nilan-y/Mini-IPA/Layout/Layout.csv

ID | Bezeichner | Footprint | Stückzahl | Bezeichnung | Anbieter und Referenz
1 | C14 | C_0402_1005Metric | 1 | 10uF
2 | C1,C2 | C_0402_1005Metric | 2 | 1uF
3 | R13 | R_2512_6332Metric | 1 | shunt
4 | R4 | R_0603_1608Metric | 1 | 0R
5 | TP2,TP1,TP7,TP14,TP3,TP15,TP16,TP8,TP12,TP5,TP4,TP6 | TestPoint_Pad_D1.0mm | 12 | Testpoint
6 | J3 | PinHeader_1x03_P2.54mm_Vertical | 1 | Conn_01x03_Pin
7 | C7,C12,C5,C8,C11,C4,C16,C17,C10,C19,C13,C9,C3,C6 | C_0402_1005Metric | 14 | 100nF
8 | R10,R2,R3,R9 | R_0402_1005Metric | 4 | 10k
9 | SW3,SW1 | SW_SPST_B3S-1000 | 2 | SW_Omron_B3FS
10 | J2 | USB_Micro-B_Amphenol_10118193-0001LF_Horizontal | 1 | USB_B_Micro
11 | Y1 | SG210STF480000ML5 | 1 | SG-210STF_8.0000ML5
12 | D2,D4,D5 | LED_0603_1608Metric | 3 | BLUE LED
13 | R7,R5,R6 | R_0402_1005Metric | 3 | 390R
14 | R8 | R_0402_1005Metric | 1 | 680R
15 | C18 | C_0402_1005Metric | 1 | n/a
16 | J1 | PinHeader_1x07_P2.54mm_Vertical_SMD_Pin1Left | 1 | Conn_01x07_Pin
17 | R18,R12,R19,R11 | R_0402_1005Metric | 4 | n/a
18 | U3 | SOT-23-5 | 1 | XC6210B332MR
19 | R21 | R_0402_1005Metric | 1 | 1k
20 | D1 | LED_0603_1608Metric | 1 | YELLOW LED
21 | IC3 | uC_Footprint | 1 | STM32F042G4U6
22 | IC4 | SOT-23-6 | 1 | MAX4231AUT+T
23 | R16 | R_0402_1005Metric | 1 | 8.2k
24 | R1 | R_0402_1005Metric | 1 | 330R
25 | R15 | R_0402_1005Metric | 1 | 10R
26 | U1 | SOT-23-5 | 1 | INA197
27 | IC1 | VL53L4CDV0DH1 | 1 | VL53L4CDV0DH_1
28 | R14 | R_0402_1005Metric | 1 | 470R
29 | D7 | RLD65NZN500A | 1 | RLD65NZN5-00A
30 | TP9,TP11,TP10 | TestPoint_Pad_2.5x2.5mm | 3 | TestPoint
31 | TR1 | SOT-23-3 | 1 | 2N7002AQ-7
32 | RN1 | R_Array_Concave_4x0603 | 1 | 100R 4x0603
33 | U4 | SOT-23-6 | 1 | ~
34 | U6 | SOT-23-6 | 1 | USBLC6-2SC6
35 | J4 | PinHeader_1x04_P2.54mm_Vertical | 1 | Conn_01x04_Pin
