nilan-y/Mini-IPA/Layout/Layout.kicad_pcb

## KiCad design Layout/Layout.kicad_pcb (2026-10-27)

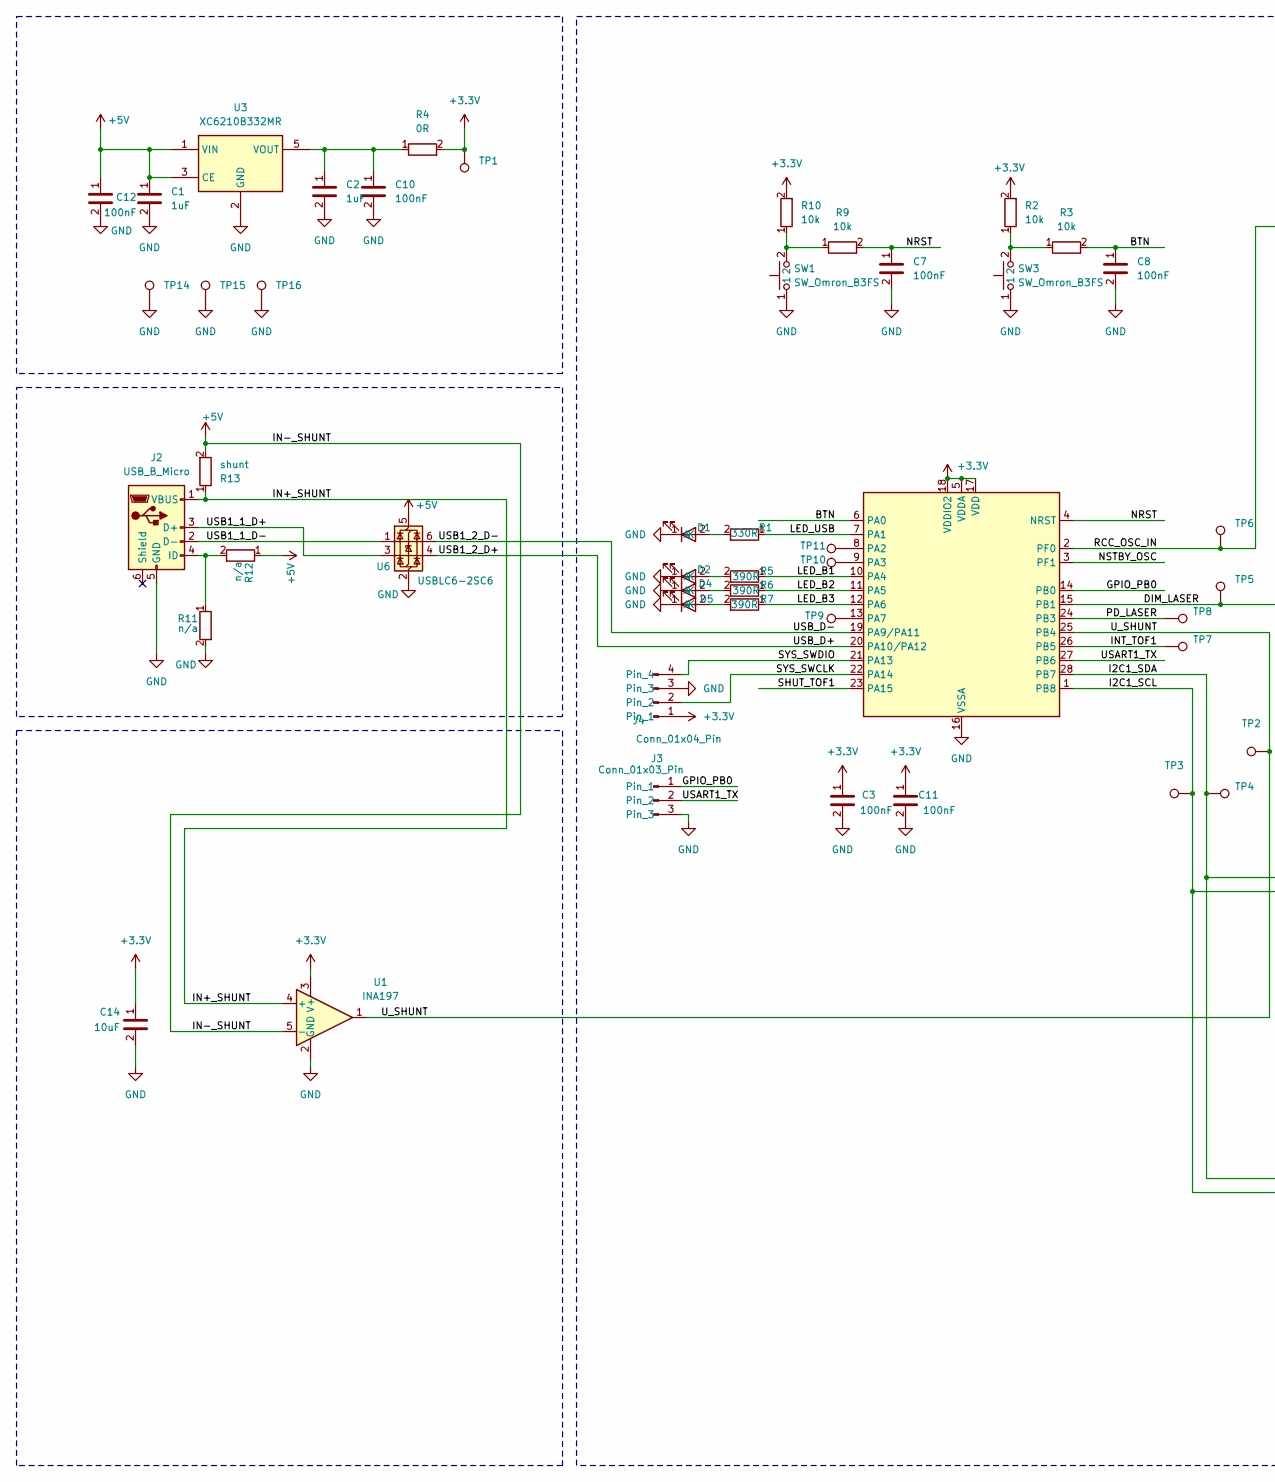
[picture p1: schematic Layout.kicad_sch, part in row 1, column 1]

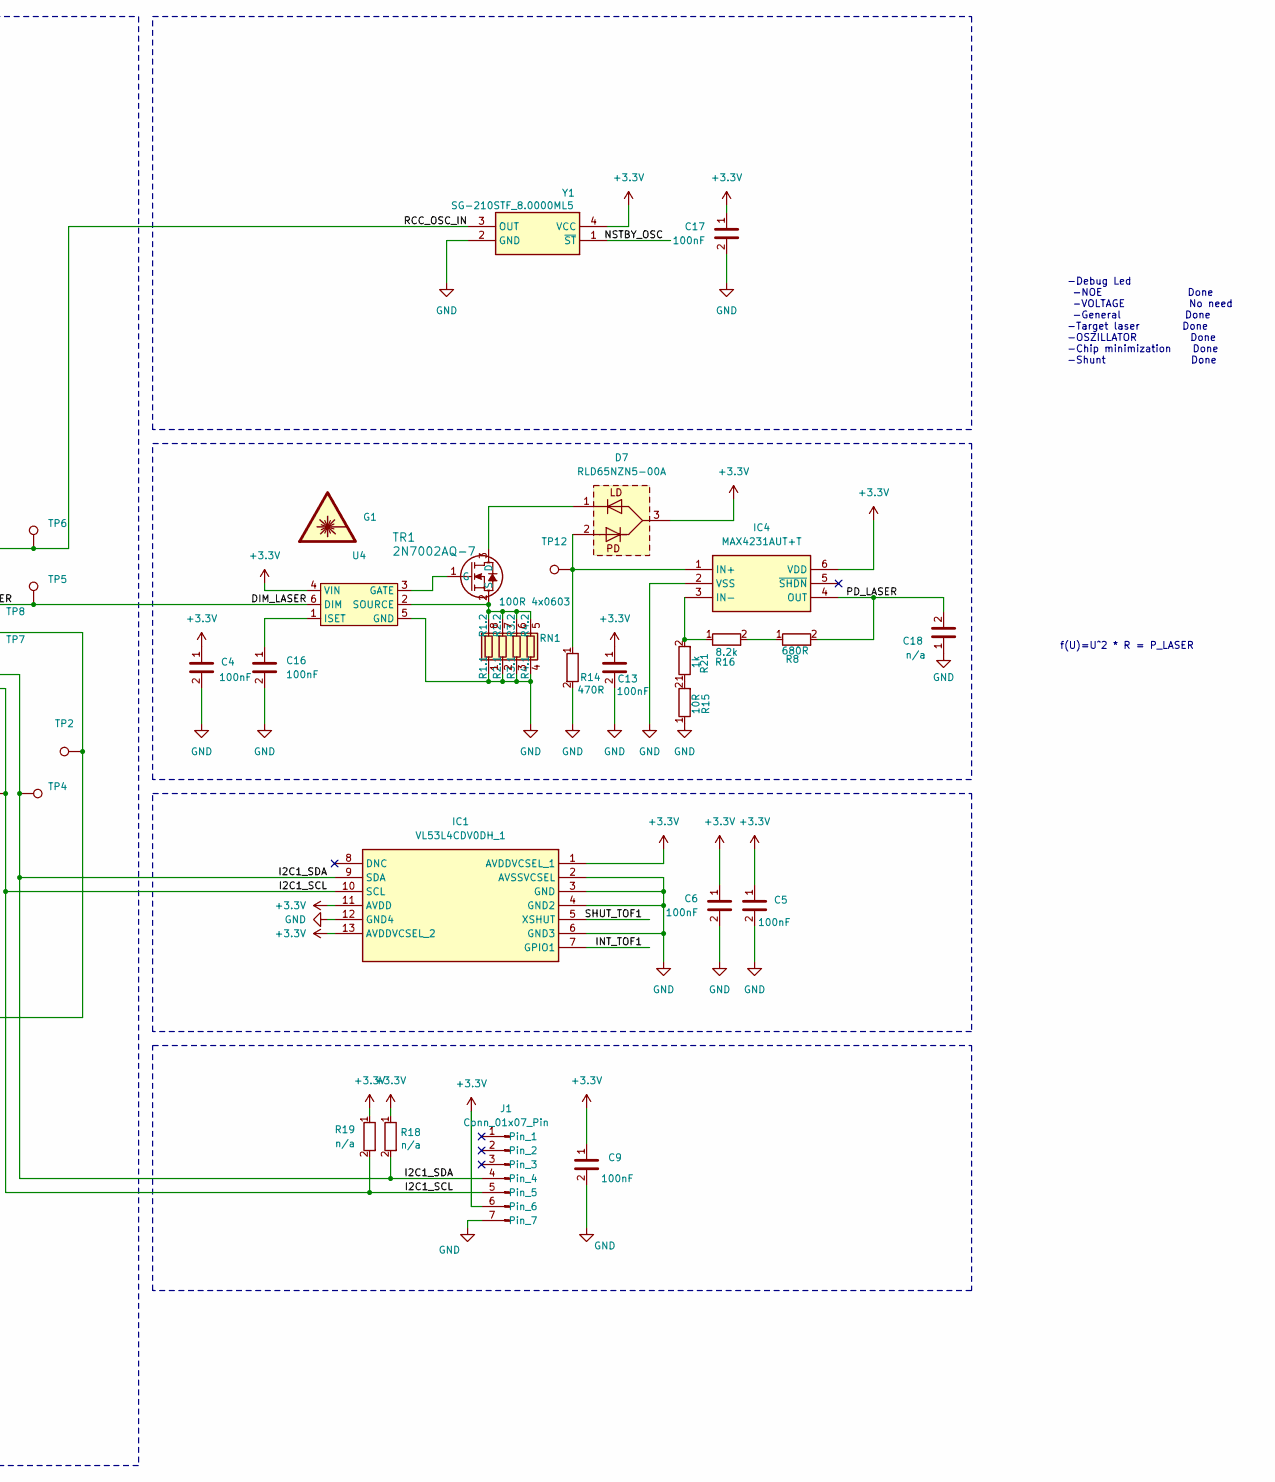
[picture p2: schematic Layout.kicad_sch, part in row 1, column 2]

Parts:
C1, C2: 1uF; C_0402_1005Metric
C3, C4, C5, C6, C7, C8, C9, C10, C11, C12, C13, C16, C17: 100nF; C_0402_1005Metric
C14: 10uF; C_0402_1005Metric
C18: n/a; C_0402_1005Metric
D1: YELLOW LED; LED_0603_1608Metric
D2, D4, D5: BLUE LED; LED_0603_1608Metric
D7: RLD65NZN5-00A; RLD65NZN500A; Mouser Part Number 755-RLD65NZN5-00A
G1: Laser_Warnschild
IC1: VL53L4CDV0DH_1; VL53L4CDV0DH1; Mouser Part Number 511-VL53L4CDV0DH/1
IC3: STM32F042G4U6; uC_Footprint; Mouser Part Number 511-STM32F042G4U6
IC4: MAX4231AUT+T; SOT-23-6; Mouser Part Number 700-MAX4231AUTT
J1: Conn_01x07_Pin; PinHeader_1x07_P2.54mm_Vertical_SMD_Pin1Left
J2: USB_B_Micro; USB_Micro-B_Amphenol_10118193-0001LF_Horizontal
J3: Conn_01x03_Pin; PinHeader_1x03_P2.54mm_Vertical
J4: Conn_01x04_Pin; PinHeader_1x04_P2.54mm_Vertical
R1: 330R; R_0402_1005Metric
R2, R3, R9, R10: 10k; R_0402_1005Metric
R4: 0R; R_0603_1608Metric
R5, R6, R7: 390R; R_0402_1005Metric
R8: 680R; R_0402_1005Metric
R11, R12, R18, R19: n/a; R_0402_1005Metric
R13: shunt; R_2512_6332Metric
R14: 470R; R_0402_1005Metric
R15: 10R; R_0402_1005Metric
R16: 8.2k; R_0402_1005Metric
R21: 1k; R_0402_1005Metric
RN1: 100R 4x0603; R_Array_Concave_4x0603
SW1, SW3: SW_Omron_B3FS; SW_SPST_B3S-1000
TP1, TP2, TP3, TP4, TP5, TP6, TP7, TP8, TP12, TP14, TP15, TP16: Testpoint; TestPoint_Pad_D1.0mm
TP9, TP10, TP11: TestPoint; TestPoint_Pad_2.5x2.5mm
TR1: 2N7002AQ-7; SOT-23-3
U1: INA197; SOT-23-5
U3: XC6210B332MR; SOT-23-5
U4: SOT-23-6
U6: USBLC6-2SC6; SOT-23-6
Y1: SG-210STF_8.0000ML5; SG210STF480000ML5; Mouser Part Number 732-SG-210STF48.0ML5

Connections:
+3.3V: C3.1, C4.1, C5.1, C6.1, C9.1, C11.1, C13.1, C14.1, C17.1, D7.3, IC1.1 (AVDDVCSEL_1), IC1.11 (AVDD), IC1.13 (AVDDVCSEL_2), IC3.5 (VDDA), IC3.17 (VDD), IC3.18 (VDDIO2), IC4.6 (VDD), J1.6, J4.1, R2.2, R4.2, R10.2, R18.1, R19.1, TP1.1, U1.3 (V+), U4.4 (VIN), Y1.4 (VCC)
+5V: C1.1, C12.1, R12.1, R13.2, U1.5 (-), U3.1 (VIN), U3.3 (CE), U6.5 (VBUS)
/BTN: C8.1, IC3.6 (PA0), R3.2
/DIM_LASER: IC3.15 (PB1), TP5.1, U4.6 (DIM)
/GPIO_PB0: IC3.14 (PB0), J3.1
/I2C1_SCL: IC1.10 (SCL), IC3.1 (PB8), J1.5, R19.2, TP3.1
/I2C1_SDA: IC1.9 (SDA), IC3.28 (PB7), J1.4, R18.2, TP4.1
/IN+_SHUNT: J2.1 (VBUS), R13.1, U1.4 (+)
/INT_TOF1: IC1.7 (GPIO1), IC3.26 (PB5), TP7.1
/LED_B1: IC3.10 (PA4), R5.1
/LED_B2: IC3.11 (PA5), R6.1
/LED_B3: IC3.12 (PA6), R7.1
/LED_USB: IC3.7 (PA1), R1.1
/NRST: C7.1, IC3.4 (NRST), R9.2
/NSTBY_OSC: IC3.3 (PF1), Y1.1 (~ST)
/PD_LASER: C18.2, IC3.24 (PB3), IC4.4 (OUT), R8.2, TP8.1
/RCC_OSC_IN: IC3.2 (PF0), TP6.1, Y1.3 (OUT)
/SHUT_TOF1: IC1.5 (XSHUT), IC3.23 (PA15)
/SYS_SWCLK: IC3.22 (PA14), J4.2
/SYS_SWDIO: IC3.21 (PA13), J4.4
/USART1_TX: IC3.27 (PB6), J3.2
/USB1_1_D+: J2.3 (D+), U6.3 (I/O2)
/USB1_1_D-: J2.2 (D-), U6.1 (I/O1)
/USB1_2_D+: IC3.20 (PA10/PA12), U6.4 (I/O2)
/USB1_2_D-: IC3.19 (PA9/PA11), U6.6 (I/O1)
/U_SHUNT: IC3.25 (PB4), TP2.1, U1.1
GND: C1.2, C2.2, C3.2, C4.2, C5.2, C6.2, C7.2, C8.2, C9.2, C10.2, C11.2, C12.2, C13.2, C14.2, C16.2, C17.2, C18.1, D1.1 (K), D2.1 (K), D4.1 (K), D5.1 (K), IC1.2 (AVSSVCSEL), IC1.3 (GND), IC1.4 (GND2), IC1.6 (GND3), IC1.12 (GND4), IC3.16 (VSSA), IC4.2 (VSS), J1.7, J2.5 (GND), J3.3, J4.3, R11.2, R14.2, R15.1, RN1.1 (R1.1), RN1.2 (R2.1), RN1.3 (R3.1), RN1.4 (R4.1), SW1.1, SW3.1, TP14.1, TP15.1, TP16.1, U1.2 (GND), U3.2 (GND), U4.5 (GND), U6.2 (GND), Y1.2 (GND)
unnamed: D1.2 (A), R1.2
unnamed: D2.2 (A), R5.2
unnamed: D4.2 (A), R6.2
unnamed: D5.2 (A), R7.2
unnamed: IC3.8 (PA2), TP11.1
unnamed: IC3.9 (PA3), TP10.1
unnamed: IC3.13 (PA7), TP9.1
unnamed: D7.2, IC4.1 (IN+), R14.1, TP12.1
unnamed: IC4.3 (IN-), R16.1, R21.2
unnamed: J2.4 (ID), R11.1, R12.2
unnamed: R2.1, R3.1, SW3.2
unnamed: R9.1, R10.1, SW1.2
unnamed: R15.2, R21.1
unnamed: R8.1, R16.2
unnamed: RN1.5 (R4.2), RN1.6 (R3.2), RN1.7 (R2.2), RN1.8 (R1.2), TR1.2 (S), U4.2 (SOURCE)
unnamed: D7.1, TR1.3 (D)
unnamed: TR1.1 (G), U4.3 (GATE)
unnamed: C2.1, C10.1, R4.1, U3.5 (VOUT)
unnamed: C16.1, U4.1 (ISET)

Notes on the sheet:
f(U)=U^2 * R = P_LASER
-Debug Led -NOE Done -VOLTAGE No need -General Done -Target laser Done -OSZILLATOR Done -Chip minimization Done -Shunt Done

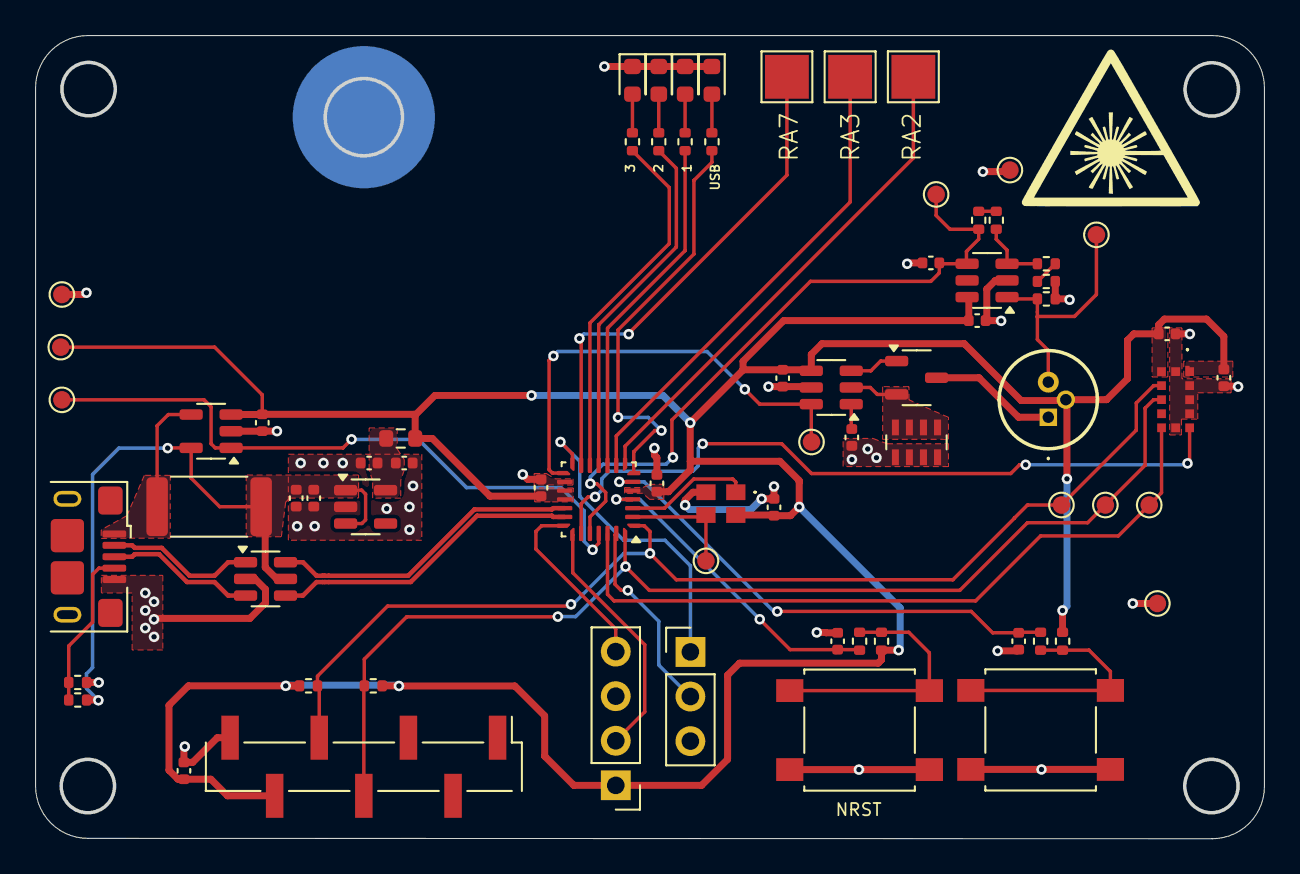
[picture p3: board Layout.kicad_pcb from above]

Board: 2 copper layers, 70.0 x 45.7 mm, 73 parts (0 on the bottom side), 46 nets.
