nilan-y/Mini-IPA/Code/Core/Src/main.c

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
/* Includes ------------------------------------------------------------------*/
#include "main.h"
#include "usb_device.h"

/* USER CODE BEGIN Includes */
#include "usb_commands.h"
#include "sensor_app.h"
#include "usbd_cdc_if.h"
#include "oled.h"
#include "custom_bus.h"
/* USER CODE END Includes */

/* USER CODE BEGIN PM */
extern I2C_HandleTypeDef hi2c1;
/* USER CODE END PM */

ADC_HandleTypeDef hadc;

TIM_HandleTypeDef htim1;

void SystemClock_Config(void);
static void MX_GPIO_Init(void);
static void MX_ADC_Init(void);
static void MX_TIM1_Init(void);
/* USER CODE BEGIN PFP */
static void ExecuteUsbCommand(uint8_t command);

/* USER CODE END PFP */

/**
  * @brief  The application entry point.
  * @retval int
  */
int main(void)
{

  /* MCU Configuration--------------------------------------------------------*/

  /* Reset of all peripherals, Initializes the Flash interface and the Systick. */
  HAL_Init();

  /* Configure the system clock */
  SystemClock_Config();

  /* Initialize all configured peripherals */
  MX_GPIO_Init();
  MX_ADC_Init();
  MX_TIM1_Init();
  MX_USB_DEVICE_Init();
  /* USER CODE BEGIN 2 */
  // Timer-Takt: 48 MHz / (47 + 1) = 1 MHz
  __HAL_TIM_SET_PRESCALER(&htim1, 47U);
  // PWM-Frequenz: 1 MHz / (999 + 1) = 1 kHz
  __HAL_TIM_SET_AUTORELOAD(&htim1, 999U);
  // Vergleichswert für 50 % Tastverhältnis
  __HAL_TIM_SET_COMPARE(&htim1, TIM_CHANNEL_3, 200U);

  HAL_GPIO_WritePin(LED_B1_GPIO_Port, LED_B1_Pin, GPIO_PIN_RESET);
  /* I2C1 is shared by the OLED (LL) and the VL53L4CD (HAL/BSP). The BSP init is
     reference counted, so calling it here once keeps the bus alive even if the
     TOF driver later calls BSP_I2C1_DeInit() on an error path. */
  if (BSP_I2C1_Init() != BSP_ERROR_NONE)
  {
    Error_Handler();
  }
  if (OLED_Init() != 0) { /* display not found */ }
  /* USER CODE END 2 */

  /* Infinite loop */
  /* USER CODE BEGIN WHILE */
  while (1)
  {
    /* USER CODE END WHILE */

    /* USER CODE BEGIN 3 */
    uint8_t command;
    CDC_ProcessActivity_FS();
    if(USB_Commands_Read(&command) != 0U)
    {
      ExecuteUsbCommand(command);
    }
    SensorApp_Process();
  }
  /* USER CODE END 3 */
}

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
/* USER CODE BEGIN 4 */
/* Called from the main loop, outside the USB interrupt. */
static void ExecuteUsbCommand(uint8_t command)
{
  switch (command)
  {
    case 1U:
    	SensorApp_StartContinuous();
    	break;
    case 2U:
    	SensorApp_Stop();
    	break;
    case 3U:
    	SensorApp_Measure();
    	break;
    case 4U:
    	HAL_TIMEx_PWMN_Start(&htim1, TIM_CHANNEL_3);
    	break;
    case 5U:
    	HAL_TIMEx_PWMN_Stop(&htim1, TIM_CHANNEL_3);
    	break;
    default: break;
  }
}

/* USER CODE END 4 */
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
