nilan-y/Mini-IPA/Code/Code.ioc

Mcu.UserName=STM32F042G6Ux
PA0.GPIO_Label=BTN
PA0.Signal=GPIO_Input
PA1.GPIO_Label=LED_USB
PA1.Signal=GPIO_Output
PA11.Signal=USB_DM
PA12.Signal=USB_DP
PA13.Signal=SYS_SWDIO
PA14.Signal=SYS_SWCLK
PA15.GPIO_Label=SHUT_TOF
PA15.Signal=GPIO_Output
PA2.GPIO_Label=PD_LASER
PA2.Signal=ADC_IN2
PA3.GPIO_Label=U_SHUNT
PA3.Signal=ADC_IN3
PA4.GPIO_Label=LED_B1
PA4.Signal=GPIO_Output
PA5.GPIO_Label=LED_B2
PA5.Signal=GPIO_Output
PA6.GPIO_Label=LED_B3
PA6.Signal=GPIO_Output
PB0.Signal=GPIO_Output
PB1.Signal=TIM1_CH3N
PB5.GPIO_Label=INT_TOF
PB5.Signal=GPXTI5
PB7.Signal=I2C1_SDA
PB8.Signal=I2C1_SCL
PF0-OSC_IN.Signal=RCC_OSC_IN
PF1-OSC_OUT.GPIO_Label=NSTBY_OSC
PF1-OSC_OUT.Signal=GPIO_Output
