nilan-y/Mini-IPA/Code/Core/Inc/main.h

#define NSTBY_OSC_Pin GPIO_PIN_1
#define NSTBY_OSC_GPIO_Port GPIOF
#define BTN_Pin GPIO_PIN_0
#define BTN_GPIO_Port GPIOA
#define LED_USB_Pin GPIO_PIN_1
#define LED_USB_GPIO_Port GPIOA
#define PD_LASER_Pin GPIO_PIN_2
#define PD_LASER_GPIO_Port GPIOA
#define U_SHUNT_Pin GPIO_PIN_3
#define U_SHUNT_GPIO_Port GPIOA
#define LED_B1_Pin GPIO_PIN_4
#define LED_B1_GPIO_Port GPIOA
#define LED_B2_Pin GPIO_PIN_5
#define LED_B2_GPIO_Port GPIOA
#define LED_B3_Pin GPIO_PIN_6
#define LED_B3_GPIO_Port GPIOA
#define SHUT_TOF_Pin GPIO_PIN_15
#define SHUT_TOF_GPIO_Port GPIOA
#define INT_TOF_Pin GPIO_PIN_5
#define INT_TOF_GPIO_Port GPIOB
