nilan-y/Mini-IPA/(commit log)

2026-09-27 Created ,gitignore
    [OPT3101RHFR.SchLib, OPT3101RHFR.stp, QFN50P400X500X100-29N-D.PcbLib, chips.prt, qfn50p400x500x100-29n-d.psm]
2026-09-30 First ICs Placed$
    [Layout.kicad_sch, Microcontroller.kicad_sch]
2026-10-08 Routine Commit, small changes in schematic
    [Microcontroller.kicad_sch, Powersupply.kicad_sch]
2026-10-09 Version with 3x VL53L4CD ToF sensors to calculate angle of measured plane
    [Layout.kicad_sch]
2026-10-10 Added: Debugging LEDs Removed: 2x Tof Sensors Merged: All Schematic sheets
    [Layout.kicad_sch]
2026-10-10 Layout merged together
    [Microcontroller.kicad_sch]
2026-10-10 Removed empty .kicad_sch files
    [Analog.kicad_sch, Microcontroller.kicad_sch, Powersupply.kicad_sch]
2026-10-12 Started with Layout
    [Layout.kicad_pcb]
2026-10-12 Last commit before short Review of Master
    [Layout.kicad_sch]
2026-10-14 Temporary commit before Atoplace usage
    [Layout.kicad_pcb]
2026-10-15 Compact version
    [Layout.kicad_pcb]
2026-10-27 Commit of STM32 uC Conifg and Production data
    [Layout-B_Adhesive.gbr, Layout-B_Cu.gbr, Layout-B_Mask.gbr, Layout-B_Paste.gbr, Layout-B_Silkscreen.gbr, Layout-Edge_Cuts.gbr, Layout-F_Adhesive.gbr, Layout-F_Cu.gbr]
2026-11-06 Handle USB commands 1-10 with STM32 action placeholders
    Parse newline-terminated UI commands, queue them for the main loop, and
    provide ten action placeholders. Include host tests and USB protocol notes.
2026-11-06 Remove unnecessary interrupt masking from USB command queue
    Use the existing single-producer/single-consumer byte queue without
    changing the global interrupt state. Remove the obsolete CMSIS test stub
    and document the existing HAL/USB CDC path and unchanged CubeMX setup.
2026-11-06 main.c Button 1/2 action => on/off led_b1
2026-11-06 Read VL53L4CD distance on button 1 and report over USB
    Use the existing ST sensor driver and I2C BSP to initialize, start, poll,
    and stop a fresh measurement. Send distance in millimeters or sensor errors
    as text lines, preserving the buffer until asynchronous USB TX completes.
    Pulse LED_USB for received and transmitted data. Preserve CubeMX setup and
    add host integration tests for sensor errors, USB backpressure and LED timing.
    [main.c, run_host_tests.py, sensor_app.c, sensor_app.h, test_sensor_usb.c]
2026-11-06 Apply known +6 mm VL53L4CD calibration offset after initialization
    Set the offset through ST's VL53L4CD_SetOffset API after every sensor
    initialization. Report an offset write error over USB and retry on the next
    request. Verify calibration ordering, failed writes and reinitialization
    in host integration tests, and document the signed correction.
    [sensor_app.c, test_sensor_usb.c]
2026-11-09 Map commands 1/2/3 to continuous start, stop and single measurement
    Use ST's asynchronous continuous ranging mode to stream results until stop.
    Process commands during measurement and USB TX so stop cancels unsent data
    without overwriting in-flight buffers. Switch an active stream to a fresh
    single shot on command 3 and queue additional single triggers.
    Preserve the updated UI response format, +6 mm offset and CubeMX setup.
    Cover streaming, stop during TX, mode changes, queued triggers and failures
    with host integration tests, and update protocol documentation.
    [main.c, sensor_app.c, sensor_app.h, test_sensor_usb.c]
