nilan-y/Mini-IPA/(notices)

Notices in the files:
Code/Core/Inc/custom_bus.h:
Copyright (c) 2026 STMicroelectronics.
All rights reserved.
This software is licensed under terms that can be found in the LICENSE file
